MF853/Calango-Tech/(commit log)

2026-07-09 Web Server Dados Sensor
2026-07-13 HTTP Server Sensor Info
2026-07-16 Adição de documentos, scripts de automação python e arquivos de simulação do coppelia
